cooper-campbell/senior_design_pcb_schematic/ratsnest.png

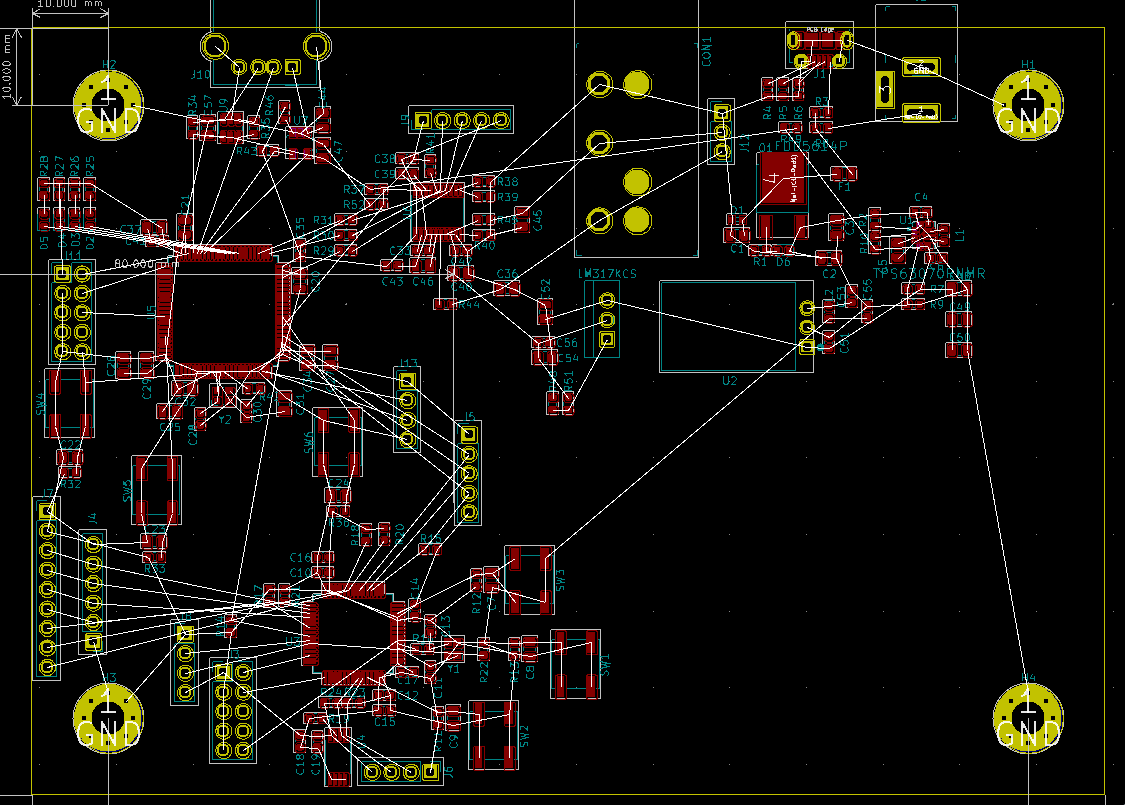
ratsnest.png
