cooper-campbell/senior_design_pcb_schematic/mosfet/eec.models/ON_Semi_-_FDD5614P.step

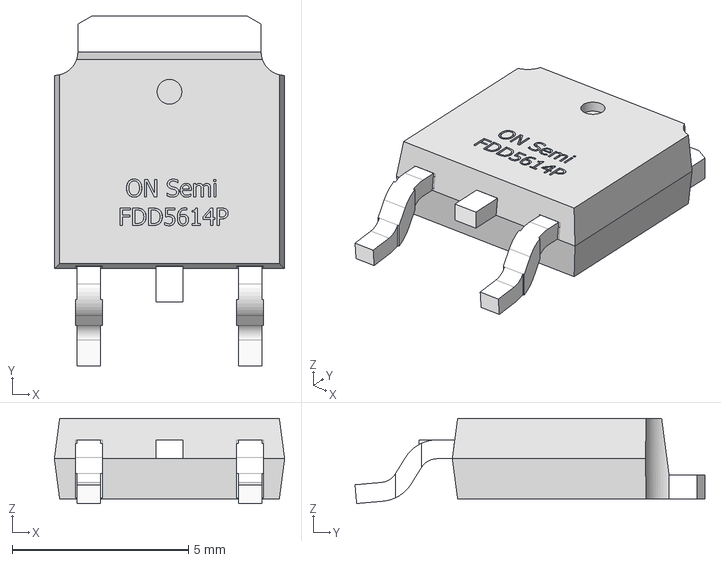
[picture p2: CAD file, 2021-03-15]
mosfet/eec.models/ON_Semi_-_FDD5614P.step
6.54 x 9.94 x 2.42 mm
