cooper-campbell/senior_design_pcb_schematic/ti/eec.models/Texas_Instruments_-_TPS63070RNMR.step

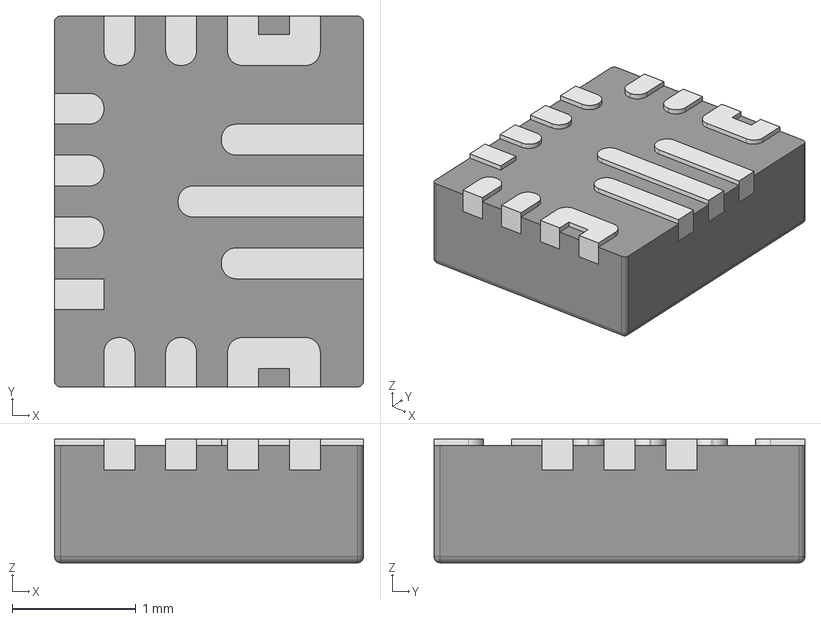
[picture p3: CAD file, 2021-03-14]
ti/eec.models/Texas_Instruments_-_TPS63070RNMR.step
2.50 x 3.00 x 1.00 mm
Texas Instruments TPS63070RNMT 1
Texas Instruments TPS63070RNMT 2
Texas ss
