cooper-campbell/senior_design_pcb_schematic/v7803/V7803-1500R.step

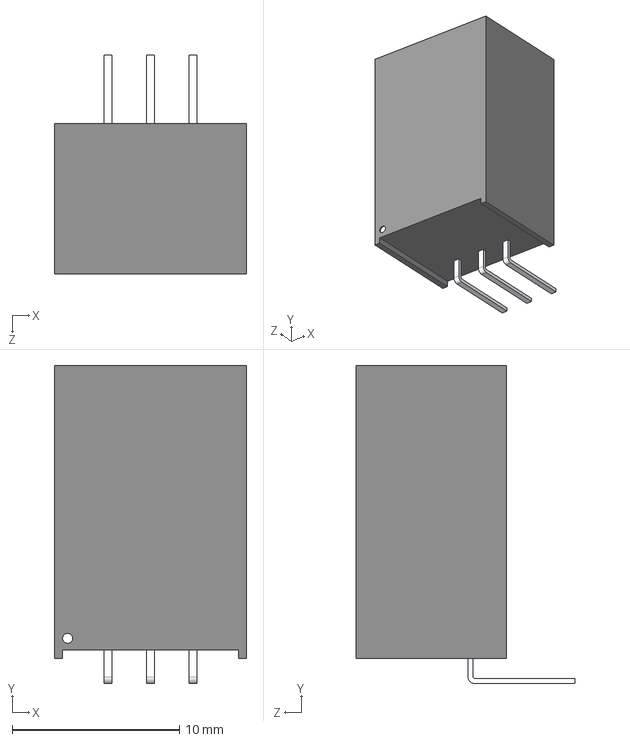
[picture p4: CAD file, 2021-03-17]
v7803/V7803-1500R.step
11.5 x 19.0 x 13.1 mm
