cooper-campbell/senior_design_pcb_schematic/pcb_layout.pdf

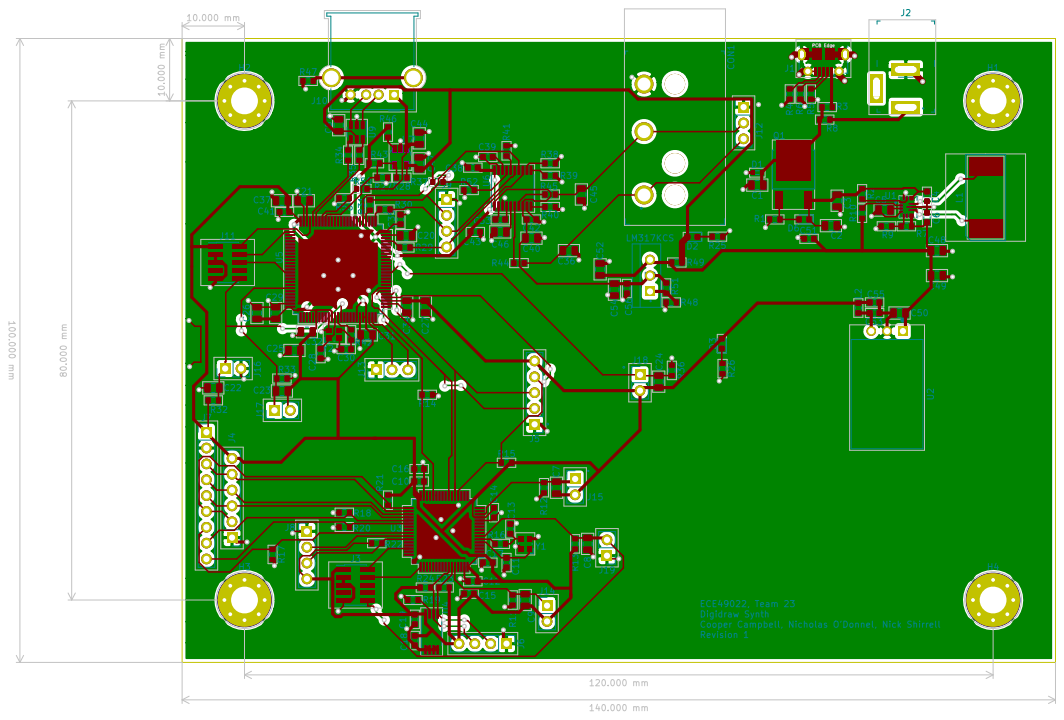
[picture p8: page 1]
