cooper-campbell/senior_design_pcb_schematic/digidraw.kicad_pcb

## KiCad design digidraw.kicad_pcb (2021-04-12)

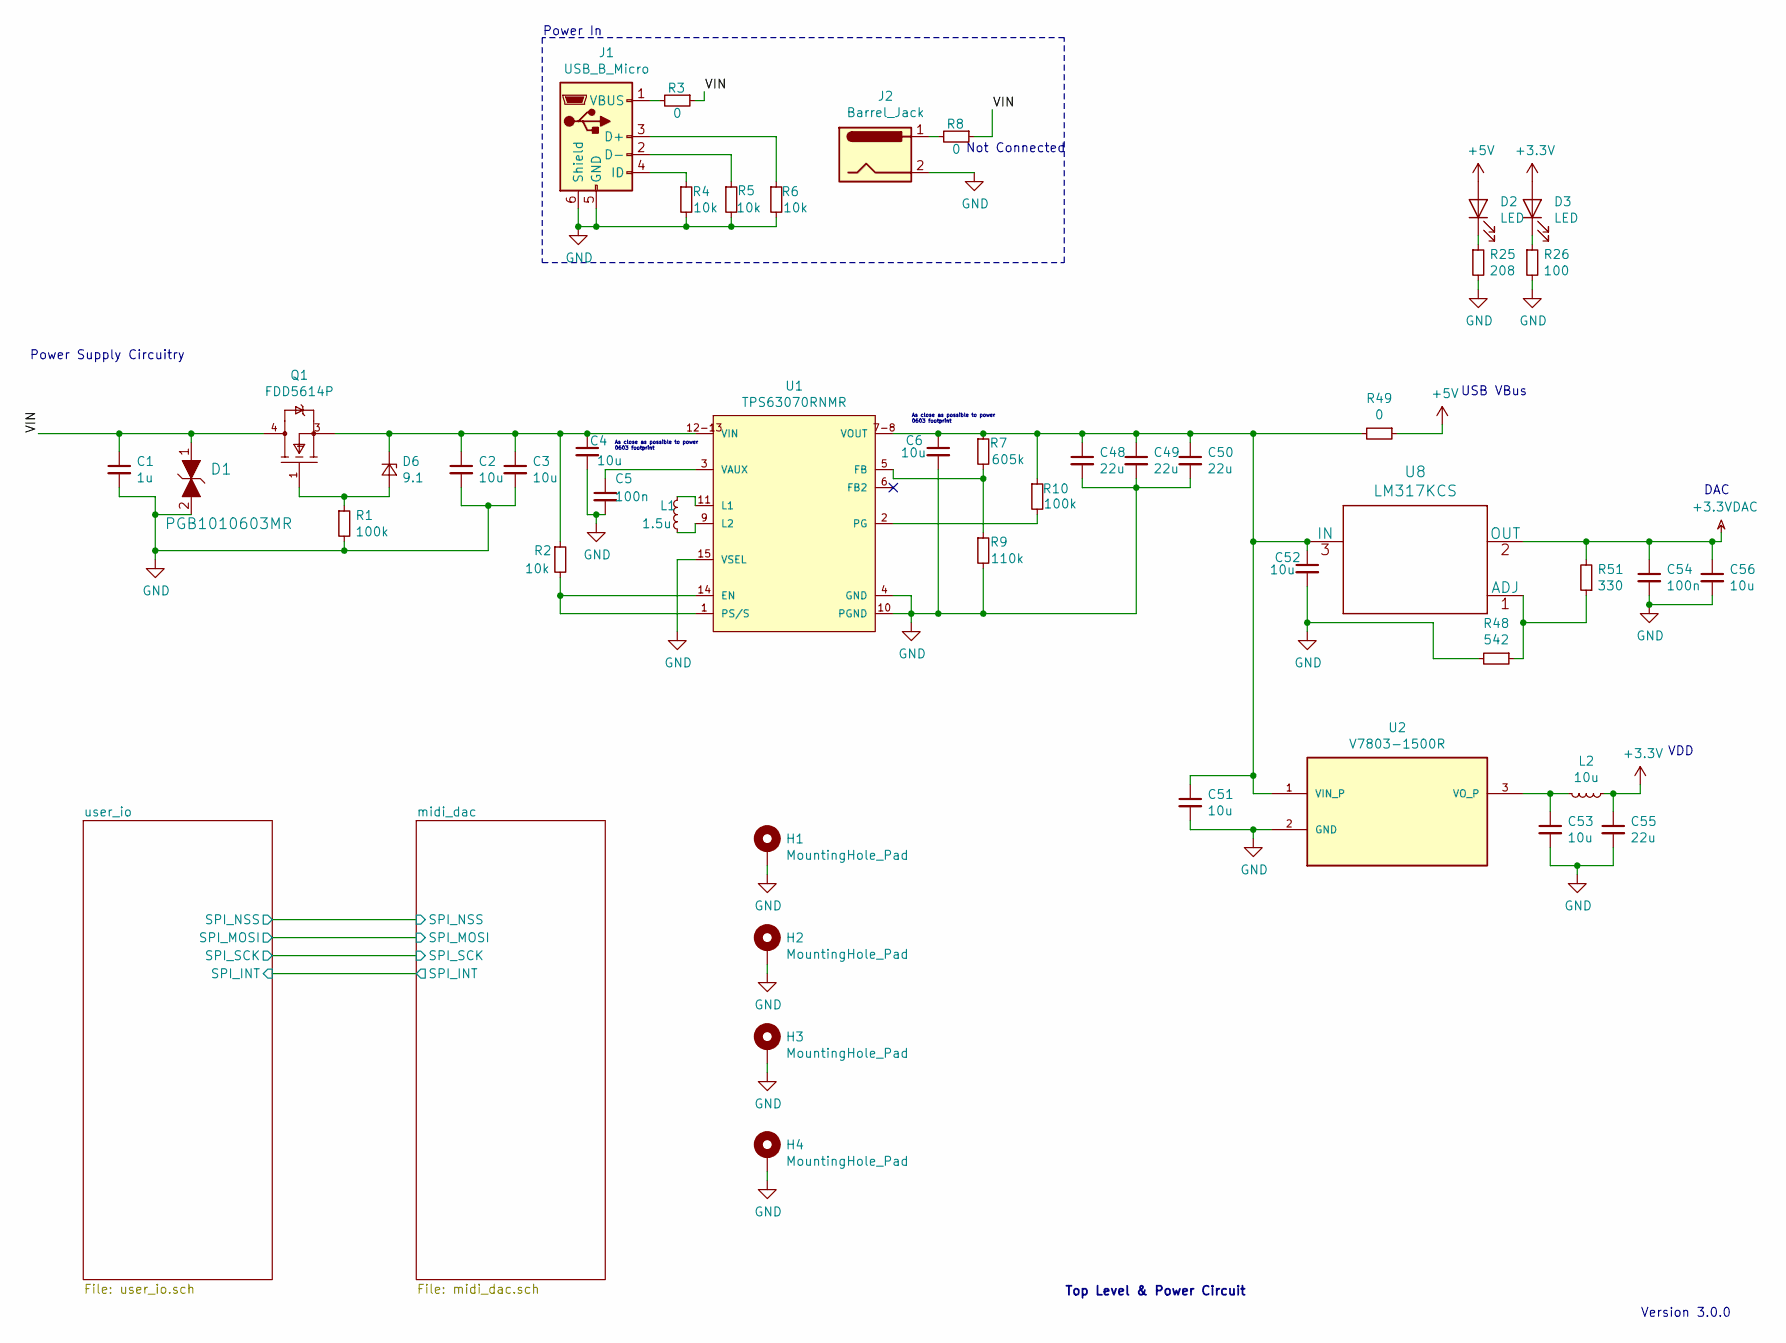
[picture p9: schematic digidraw.sch]

Parts:
C1: 1u; C_0805_2012Metric; Min Voltage Rating 16 V
C2, C3: 10u; C_0805_2012Metric; Min Voltage Rating 16 V
C4: 10u; C_0603_1608Metric; Min Voltage Rating 16 V
C5: 100n; C_0805_2012Metric; Min Voltage Rating 16 V
C6: 10u; C_0603_1608Metric; Min Voltage Rating 5.2 V
C48, C49, C50: 22u; C_0805_2012Metric; Min Voltage Rating 5.2 V
C51, C53: 10u; C_0603_1608Metric
C52: 10u; C_0805_2012Metric; Min Voltage Rating 5.2 V
C54: 100n; C_0805_2012Metric; Min Voltage Rating 3.3 V
C55: 22u; C_0603_1608Metric; Min Voltage Rating 3.3 V
C56: 10u; C_0603_1608Metric; Min Voltage Rating 3.3 V
D1: PGB1010603MR; 0603; MPN PGB1010603MR; Digi-Key_PN F2594CT-ND
D2, D3: LED; LED_0603_1608Metric; Digi-Key_PN AA1608SURSK
D6: 9.1; D_0603_1608Metric; Digi-Key_PN CDBU0320
H1, H2, H3, H4: MountingHole_Pad; MountingHole_4.3mm_M4_Pad_Via
J1: USB_B_Micro; USB_Micro-B_Molex-105017-0001; Digi-Key_PN 105017-0001
J2: Barrel_Jack; Barrel_Jack_5.5mmODx2.1mmID_PJ-202A; Digi-Key_PN PJ-202A
L1: 1.5u; InductorWEPD; Digi-Key_PN 7447707015
L2: 10u; L_0603_1608Metric; Digi-Key_PN MLZ1608E100MT
Q1: FDD5614P; ON_Semi-369AS-09_2016-O-0; mouser part number 512-FDD5614P; digikey description MOSFET P-CH 60V 15A DPAK
R1, R10: 100k; R_0603_1608Metric
R2, R4, R5, R6: 10k; R_0603_1608Metric
R3, R8, R49: 0; R_0603_1608Metric
R7: 605k; R_0603_1608Metric
R9: 110k; R_0603_1608Metric
R25: 208; R_0603_1608Metric
R26: 100; R_0603_1608Metric
R48: 542; R_0603_1608Metric
R51: 330; R_0603_1608Metric
U1: TPS63070RNMR; Texas_Instruments-RNM0015A-0-0-MFG; output voltage 2.5-9V; mouser part number 595-TPS63070RNMR; digikey description IC REG BCK BST ADJ 3.6A 15VQFN
U2: V7803-1500R; CONV_V7803-1500R; PARTREV 1.03; Digi-Key_PN V7803-1500R
U8: LM317KCS; Digi-Key_PN LM317KCS

Connections:
+3.3VDAC: C54.1, C56.1, R51.2, U8.2 (OUT); also elsewhere on the board
+3V3: C55.1, D3.2 (A), L2.1; also elsewhere on the board
+5V: D2.2 (A), R49.1; also elsewhere on the board
/VIN: C1.1, D1.1, Q1.4 (D), R3.1, R8.1
GND: C1.2, C2.2, C3.2, C4.2, C5.2, C6.2, C48.2, C49.2, C50.2, C51.2, C52.2, C53.2, C54.2, C55.2, C56.2, D1.2, H1.1, H2.1, H3.1, H4.1, J1.5 (GND), J1.6 (Shield), J2.2, R1.2, R4.2, R5.2, R6.2, R9.2, R25.2, R26.2, R48.2, U1.4 (GND), U1.10 (PGND), U1.15 (VSEL), U2.2 (GND); also elsewhere on the board
unnamed: C2.1, C3.1, C4.1, D6.1 (K), Q1.3 (S), R2.1, U1.12-13 (VIN)
unnamed: C5.1, U1.3 (VAUX)
unnamed: C6.1, C48.1, C49.1, C50.1, C51.1, C52.1, R7.1, R10.1, R49.2, U1.7-8 (VOUT), U2.1 (VIN_P), U8.3 (IN)
unnamed: C53.1, L2.2, U2.3 (VO_P)
unnamed: D2.1 (K), R25.1
unnamed: D3.1 (K), R26.1
unnamed: D6.2 (A), Q1.1 (G), R1.1
unnamed: J1.1 (VBUS), R3.2
unnamed: J1.2 (D-), R5.1
unnamed: J1.3 (D+), R6.1
unnamed: J1.4 (ID), R4.1
unnamed: J2.1, R8.2
unnamed: L1.1, U1.9 (L2)
unnamed: L1.2, U1.11 (L1)
unnamed: R2.2, U1.1 (PS/S), U1.14 (EN)
unnamed: R7.2, R9.1, U1.5 (FB)
unnamed: R10.2, U1.2 (PG)
unnamed: R48.1, R51.1, U8.1 (ADJ)

Notes on the sheet:
Power In
Top Level & Power Circuit
Version 3.0.0
Not Connected
As close as possible to power 0603 footprint
USB VBus
VDD
DAC
Power Supply Circuitry

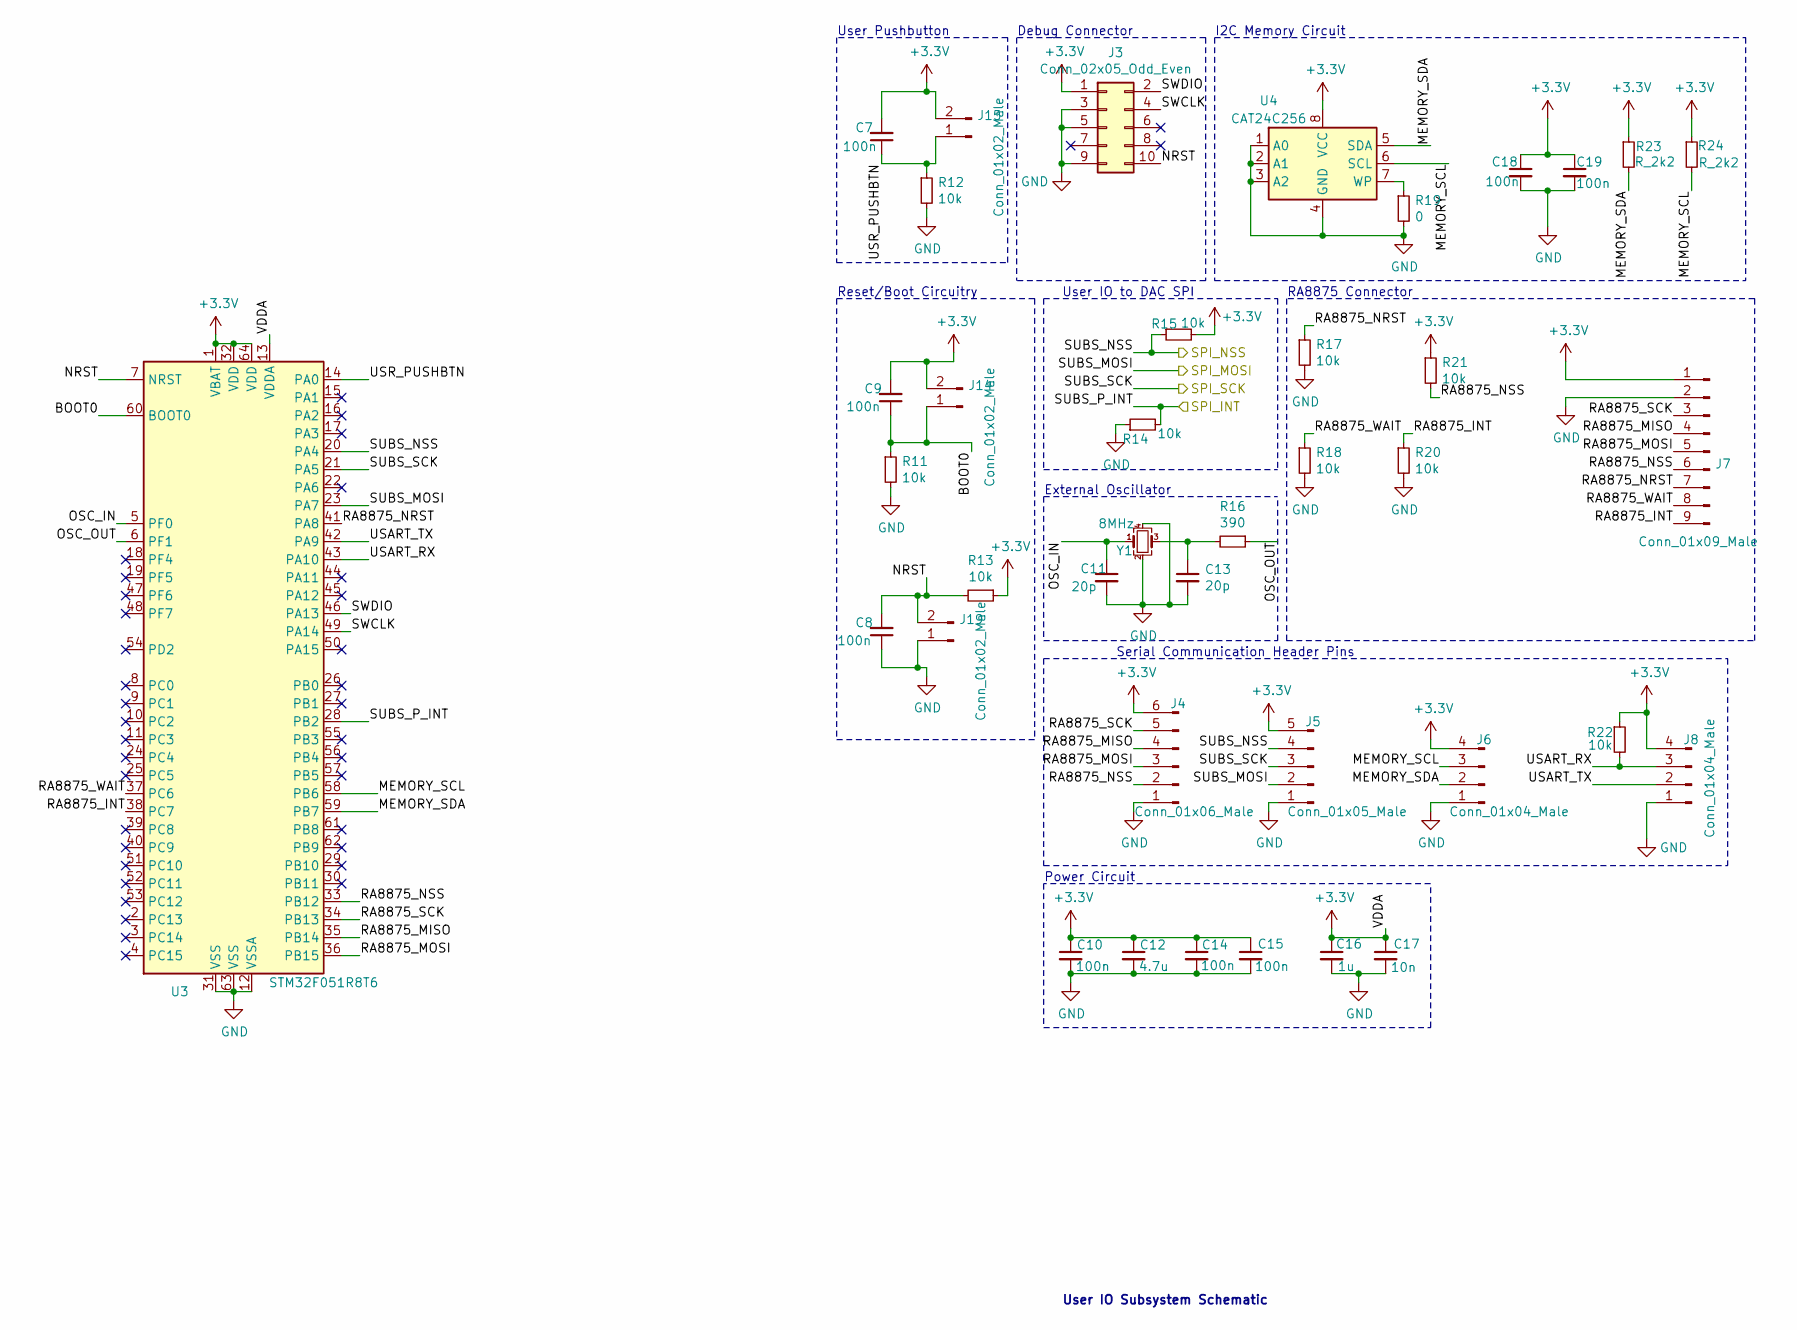
[picture p10: schematic user_io.sch]

Parts:
C7, C8, C9: 100n; C_0805_2012Metric; Min Voltage Rating 3.3 V
C10, C14, C15, C18, C19: 100n; C_0603_1608Metric; Min Voltage Rating 3.3 V
C11, C13: 20p; C_0603_1608Metric; Min Voltage Rating 3.3 V
C12: 4.7u; C_0603_1608Metric; Min Voltage Rating 3.3 V
C16: 1u; C_0603_1608Metric; Min Voltage Rating 3.3 V
C17: 10n; C_0603_1608Metric
J3: Conn_02x05_Odd_Even; PinHeader_2x05_P1.27mm_Vertical_SMD
J4: Conn_01x06_Male; PinHeader_1x06_P2.54mm_Vertical
J5: Conn_01x05_Male; PinHeader_1x05_P2.54mm_Vertical
J6, J8: Conn_01x04_Male; PinHeader_1x04_P2.54mm_Vertical
J7: Conn_01x09_Male; PinHeader_1x09_P2.54mm_Vertical
J14, J15, J19: Conn_01x02_Male; PinHeader_1x02_P2.54mm_Vertical
R11, R12, R13, R14, R15, R17, R18, R20, R21, R22: 10k; R_0603_1608Metric
R16: 390; R_0603_1608Metric
R19: 0; R_0603_1608Metric
R23, R24: R_2k2; R_0603_1608Metric
U3: STM32F051R8T6; LQFP-64_10x10mm_P0.5mm; Digi-Key_PN STM32F051R8T6
U4: CAT24C256; TSSOP-8_4.4x3mm_P0.65mm; Digi-Key_PN CAT24C256YI-GT3
Y1: 8MHz; Crystal_SMD_Abracon_ABM10-4Pin_2.5x2.0mm; Digi-Key_PN ASDDV-8.000MHZ-LR-T

Connections:
+3V3: C7.2, C9.2, C10.1, C12.1, C14.1, C15.1, C16.1, C17.1, C18.1, C19.1, J3.1, J4.6, J5.5, J6.4, J7.1, J8.4, J14.2, J15.2, R13.1, R15.2, R21.1, R22.1, R23.1, R24.1, U3.1 (VBAT), U3.13 (VDDA), U3.32 (VDD), U3.64 (VDD), U4.8 (VCC); also elsewhere on the board
/midi_dac/SPI_INT: R14.2, U3.28 (PB2); also elsewhere on the board
/midi_dac/SPI_MOSI: J5.2, U3.23 (PA7); also elsewhere on the board
/midi_dac/SPI_NSS: J5.4, R15.1, U3.20 (PA4); also elsewhere on the board
/midi_dac/SPI_SCK: J5.3, U3.21 (PA5); also elsewhere on the board
/user_io/BOOT0: C9.1, J14.1, R11.1, U3.60 (BOOT0)
/user_io/MEMORY_SCL: J6.3, R24.2, U3.58 (PB6), U4.6 (SCL)
/user_io/MEMORY_SDA: J6.2, R23.2, U3.59 (PB7), U4.5 (SDA)
/user_io/NRST: C8.2, J3.10, J19.2, R13.2, U3.7 (NRST)
/user_io/OSC_IN: C11.1, U3.5 (PF0), Y1.1
/user_io/OSC_OUT: R16.1, U3.6 (PF1)
/user_io/RA8875_INT: J7.9, R20.1, U3.38 (PC7)
/user_io/RA8875_MISO: J4.4, J7.4, U3.35 (PB14)
/user_io/RA8875_MOSI: J4.3, J7.5, U3.36 (PB15)
/user_io/RA8875_NRST: J7.7, R17.1, U3.41 (PA8)
/user_io/RA8875_NSS: J4.2, J7.6, R21.2, U3.33 (PB12)
/user_io/RA8875_SCK: J4.5, J7.3, U3.34 (PB13)
/user_io/RA8875_WAIT: J7.8, R18.1, U3.37 (PC6)
/user_io/SWCLK: J3.4, U3.49 (PA14)
/user_io/SWDIO: J3.2, U3.46 (PA13)
/user_io/USART_RX: J8.3, R22.2, U3.43 (PA10)
/user_io/USART_TX: J8.2, U3.42 (PA9)
/user_io/USR_PUSHBTN: C7.1, J15.1, R12.1, U3.14 (PA0)
GND: C8.1, C10.2, C11.2, C12.2, C13.2, C14.2, C15.2, C16.2, C17.2, C18.2, C19.2, J3.3, J3.5, J3.9, J4.1, J5.1, J6.1, J7.2, J8.1, J19.1, R11.2, R12.2, R14.1, R17.2, R18.2, R19.2, R20.2, U3.12 (VSSA), U3.31 (VSS), U3.63 (VSS), U4.1 (A0), U4.2 (A1), U4.3 (A2), U4.4 (GND), Y1.2, Y1.4; also elsewhere on the board
unnamed: C13.1, R16.2, Y1.3
unnamed: R19.1, U4.7 (WP)

Notes on the sheet:
I2C Memory Circuit
User IO to DAC SPI
RA8875 Connector
User IO Subsystem Schematic
Reset/Boot Circuitry
Debug Connector
Power Circuit
Serial Communication Header Pins
External Oscillator
User Pushbutton

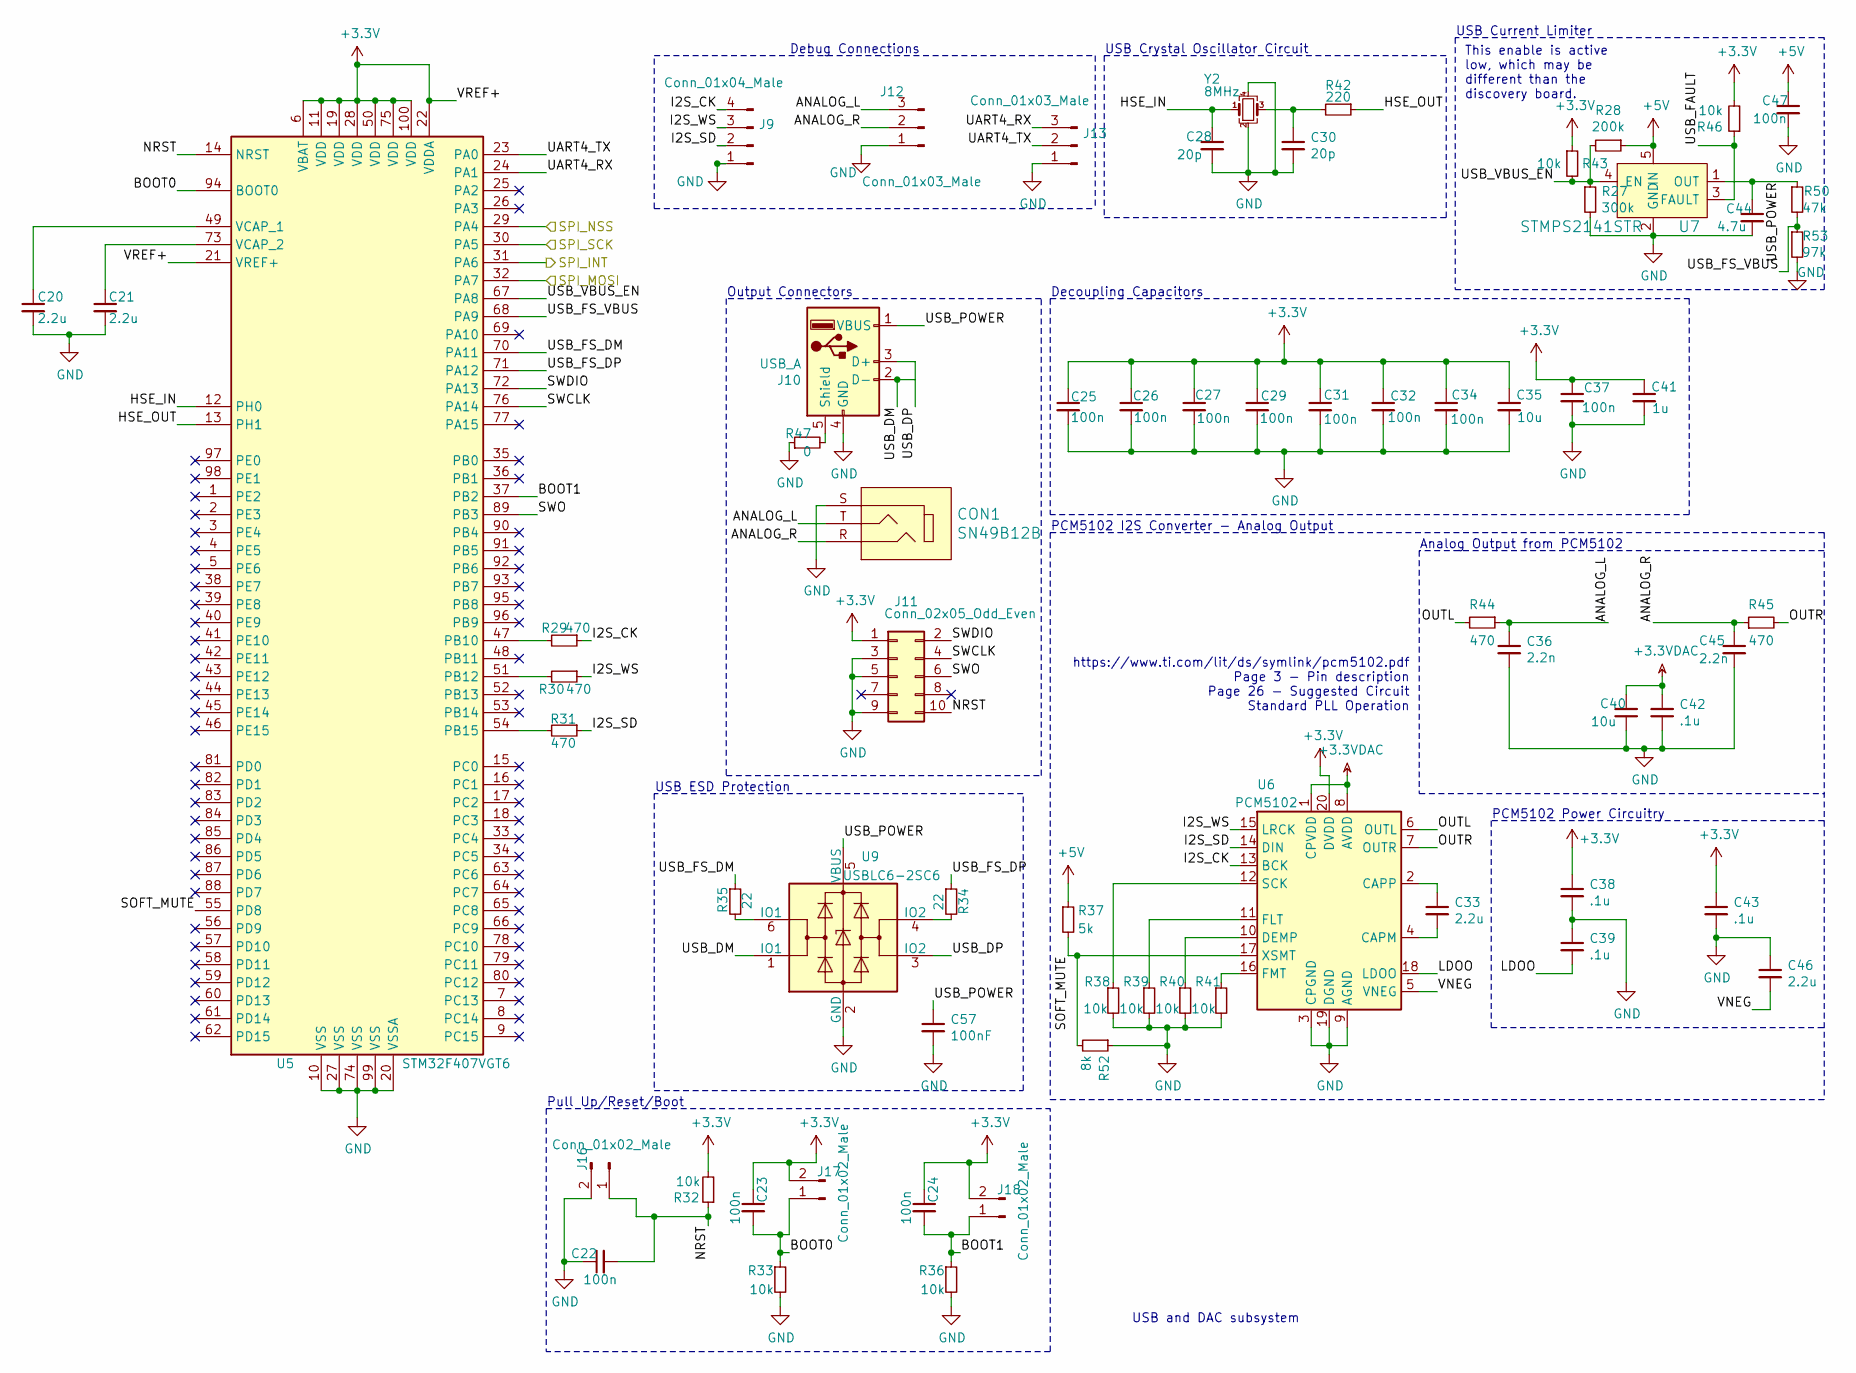
[picture p11: schematic midi_dac.sch]

Parts:
C20, C21, C46: 2.2u; C_0805_2012Metric; Min Voltage Rating 3.3 V
C22, C23, C24, C25, C26, C27, C29, C31, C32, C34, C37: 100n; C_0805_2012Metric; Min Voltage Rating 3.3 V
C28, C30: 20p; C_0603_1608Metric; Min Voltage Rating 3.3 V
C33: 2.2u; C_0603_1608Metric; Min Voltage Rating 3.3 V
C35: 10u; C_0603_1608Metric; Min Voltage Rating 3.3 V
C36, C45: 2.2n; C_0805_2012Metric; Min Voltage Rating 3.3 V
C38, C39, C42, C43: .1u; C_0603_1608Metric; Min Voltage Rating 3.3 V
C40: 10u; C_0805_2012Metric; Min Voltage Rating 3.3 V
C41: 1u; C_0603_1608Metric; Min Voltage Rating 3.3 V
C44: 4.7u; C_0805_2012Metric; Min Voltage Rating 5.2 V
C47: 100n; C_0805_2012Metric; Min Voltage Rating 5.2 V
C57: 100nF; C_0805_2012Metric; Min Voltage Rating 5.2 V
CON1: SN49B12B; Headphone_Jack_6.35mm_SN49B12B; MPN SN49B12B; Digi-Key_PN SC1522-ND
J9: Conn_01x04_Male; PinHeader_1x04_P2.54mm_Vertical
J10: USB_A; USB_A_Molex_67643_Horizontal; Digi-Key_PN 67643-3910
J11: Conn_02x05_Odd_Even; PinHeader_2x05_P1.27mm_Vertical_SMD
J12, J13: Conn_01x03_Male; PinHeader_1x03_P2.54mm_Vertical
J16, J17, J18: Conn_01x02_Male; PinHeader_1x02_P2.54mm_Vertical
R27: 300k; R_0603_1608Metric
R28: 200k; R_0603_1608Metric
R29, R30, R31, R44, R45: 470; R_0603_1608Metric
R32, R33, R36, R38, R39, R40, R41, R43, R46: 10k; R_0603_1608Metric
R34, R35: 22; R_0603_1608Metric
R37: 5k; R_0603_1608Metric
R42: 220; R_0603_1608Metric
R47: 0; R_0603_1608Metric
R50: 47k; R_0603_1608Metric
R52: 8k; R_0603_1608Metric
R53: 97k; R_0603_1608Metric
U5: STM32F407VGT6; LQFP-100_14x14mm_P0.5mm; Digi-Key_PN STM32F407VGT6
U6: PCM5102; TSSOP-20_4.4x6.5mm_P0.65mm; Digi-Key_PN PCM5102APWR
U7: STMPS2141STR; SOT-753; MPN STMPS2141STR; Digi-Key_PN 497-6933-1-ND
U9: USBLC6-2SC6; SOT-23-6; Digi-Key_PN USBLC6-2SC6
Y2: 8MHz; Crystal_SMD_Abracon_ABM10-4Pin_2.5x2.0mm; Digi-Key_PN ASDDV-8.000MHZ-LR-T

Connections:
+3.3VDAC: C40.2, C42.2, U6.1 (CPVDD), U6.8 (AVDD); also elsewhere on the board
+3V3: C23.1, C24.1, C25.1, C26.1, C27.1, C29.1, C31.1, C32.1, C34.1, C35.1, C37.1, C38.1, C41.1, C43.1, J11.1, J17.2, J18.2, R32.2, R43.1, R46.2, U5.6 (VBAT), U5.11 (VDD), U5.19 (VDD), U5.21 (VREF+), U5.22 (VDDA), U5.28 (VDD), U5.50 (VDD), U5.75 (VDD), U5.100 (VDD), U6.20 (DVDD); also elsewhere on the board
+5V: C47.1, R28.1, R37.1, U7.5 (IN); also elsewhere on the board
/midi_dac/ANALOG_L: C36.1, CON1.T, J12.3, R44.1
/midi_dac/ANALOG_R: C45.1, CON1.R, J12.2, R45.1
/midi_dac/BOOT0: C23.2, J17.1, R33.1, U5.94 (BOOT0)
/midi_dac/BOOT1: C24.2, J18.1, R36.1, U5.37 (PB2)
/midi_dac/HSE_IN: C28.1, U5.12 (PH0), Y2.1
/midi_dac/HSE_OUT: R42.1, U5.13 (PH1)
/midi_dac/I2S_CK: J9.4, R29.1, U6.13 (BCK)
/midi_dac/I2S_SD: J9.2, R31.1, U6.14 (DIN)
/midi_dac/I2S_WS: J9.3, R30.1, U6.15 (LRCK)
/midi_dac/LDOO: C39.2, U6.18 (LDOO)
/midi_dac/NRST: C22.2, J11.10, J16.1, R32.1, U5.14 (NRST)
/midi_dac/OUTL: R44.2, U6.6 (OUTL)
/midi_dac/OUTR: R45.2, U6.7 (OUTR)
/midi_dac/SOFT_MUTE: R37.2, R52.2, U5.55 (PD8), U6.17 (XSMT)
/midi_dac/SPI_INT: U5.31 (PA6); also elsewhere on the board
/midi_dac/SPI_MOSI: U5.32 (PA7); also elsewhere on the board
/midi_dac/SPI_NSS: U5.29 (PA4); also elsewhere on the board
/midi_dac/SPI_SCK: U5.30 (PA5); also elsewhere on the board
/midi_dac/SWCLK: J11.4, U5.76 (PA14)
/midi_dac/SWDIO: J11.2, U5.72 (PA13)
/midi_dac/SWO: J11.6, U5.89 (PB3)
/midi_dac/UART4_RX: J13.3, U5.24 (PA1)
/midi_dac/UART4_TX: J13.2, U5.23 (PA0)
/midi_dac/USB_DM: J10.2 (D-), U9.1 (IO1)
/midi_dac/USB_DP: J10.3 (D+), U9.3 (IO2)
/midi_dac/USB_FAULT: R46.1, U7.3 (FAULT)
/midi_dac/USB_FS_DM: R35.1, U5.70 (PA11)
/midi_dac/USB_FS_DP: R34.1, U5.71 (PA12)
/midi_dac/USB_FS_VBUS: R50.2, R53.1, U5.68 (PA9)
/midi_dac/USB_POWER: C44.1, C57.1, J10.1 (VBUS), R50.1, U7.1 (OUT), U9.5 (VBUS)
/midi_dac/USB_VBUS_EN: R27.1, R28.2, R43.2, U5.67 (PA8), U7.4 (EN)
/midi_dac/VNEG: C46.2, U6.5 (VNEG)
GND: C20.2, C21.2, C22.1, C25.2, C26.2, C27.2, C28.2, C29.2, C30.2, C31.2, C32.2, C34.2, C35.2, C36.2, C37.2, C38.2, C39.1, C40.1, C41.2, C42.1, C43.2, C44.2, C45.2, C46.1, C47.2, C57.2, CON1.S, J9.1, J10.4 (GND), J11.3, J11.5, J11.9, J12.1, J13.1, J16.2, R27.2, R33.2, R36.2, R38.2, R39.2, R40.2, R41.2, R47.1, R52.1, R53.2, U5.10 (VSS), U5.20 (VSSA), U5.27 (VSS), U5.74 (VSS), U5.99 (VSS), U6.3 (CPGND), U6.9 (AGND), U6.19 (DGND), U7.2 (GND), U9.2 (GND), Y2.2, Y2.4; also elsewhere on the board
unnamed: C20.1, U5.49 (VCAP_1)
unnamed: C21.1, U5.73 (VCAP_2)
unnamed: C30.1, R42.2, Y2.3
unnamed: C33.1, U6.2 (CAPP)
unnamed: C33.2, U6.4 (CAPM)
unnamed: J10.5 (Shield), R47.2
unnamed: R29.2, U5.47 (PB10)
unnamed: R30.2, U5.51 (PB12)
unnamed: R31.2, U5.54 (PB15)
unnamed: R34.2, U9.4 (IO2)
unnamed: R35.2, U9.6 (IO1)
unnamed: R38.1, U6.12 (SCK)
unnamed: R39.1, U6.11 (FLT)
unnamed: R40.1, U6.10 (DEMP)
unnamed: R41.1, U6.16 (FMT)

Notes on the sheet:
Decoupling Capacitors
USB Crystal Oscillator Circuit
https://www.ti.com/lit/ds/symlink/pcm5102.pdf Page 3 - Pin description Page 26 - Suggested Circuit Standard PLL Operation
Analog Output from PCM5102
PCM5102 Power Circuitry
PCM5102 I2S Converter - Analog Output
This enable is active low, which may be different than the discovery board.
USB Current Limiter
Pull Up/Reset/Boot
Output Connectors
USB and DAC subsystem
Debug Connections
USB ESD Protection

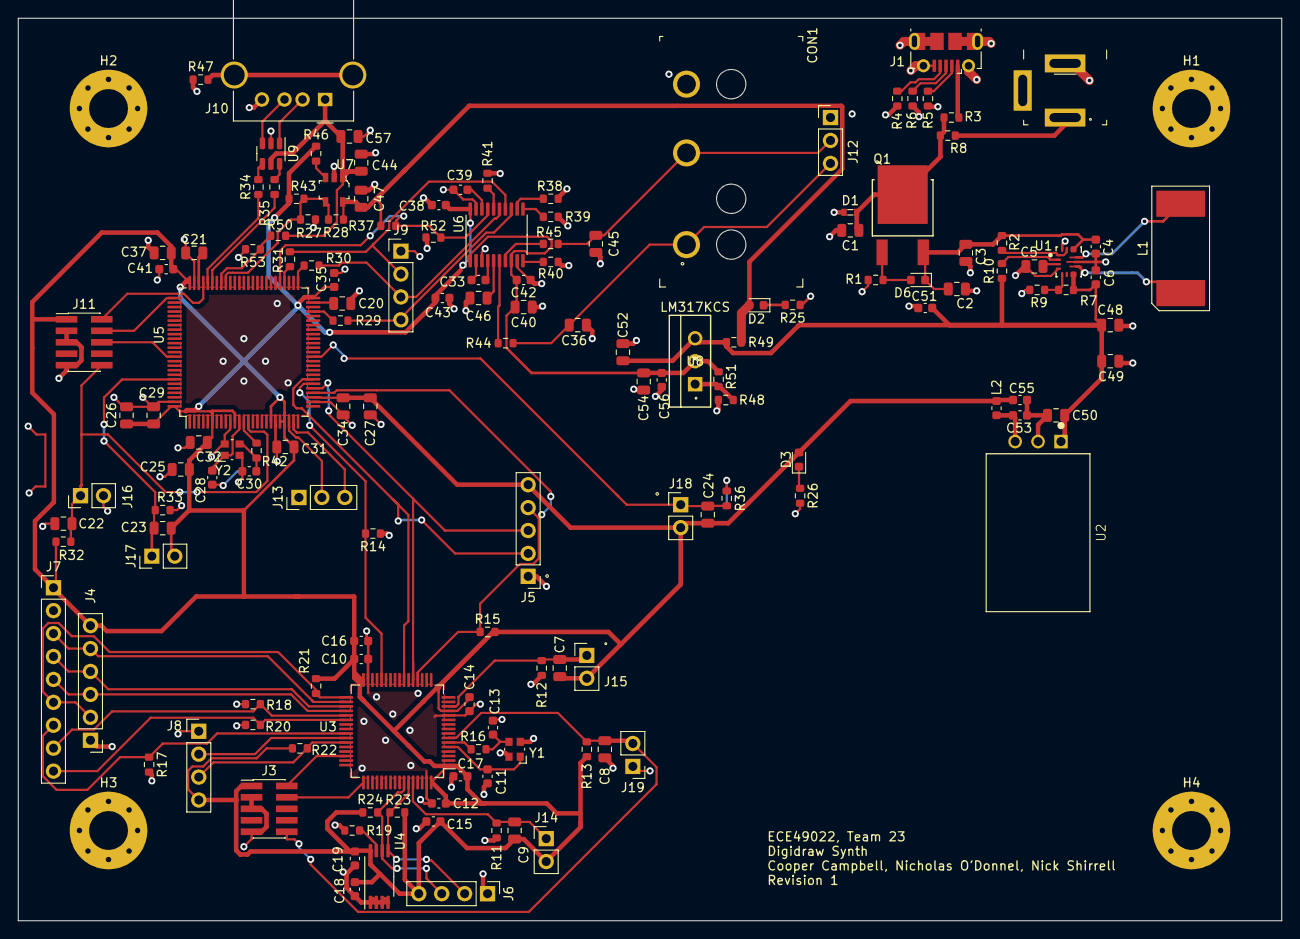
[picture p12: board digidraw.kicad_pcb from above]

Board: 2 copper layers, 140.0 x 100.0 mm, 152 parts (0 on the bottom side), 90 nets.
