cooper-campbell/senior_design_pcb_schematic/(commit log)

2021-03-07 Initial, add mcus
    [digidraw.kicad_pcb, digidraw.sch, midi_dac.sch, user_io.sch]
2021-03-07 Work on user io subsystem schematic
    [digidraw.sch, midi_dac.sch, user_io.sch]
2021-03-09 Add f4 decoupling capacitors, add dac, add power converter circuit
    [digidraw.sch, midi_dac.sch, user_io.sch]
2021-03-12 Finish prototype of DAC/USB/Power system
    [digidraw.sch, midi_dac.sch, user_io.sch]
2021-03-12 Finish screen subsystem
    [midi_dac.sch, user_io.sch]
2021-03-12 Add one more debug connector
    [digidraw.sch, midi_dac.sch]
2021-03-12 Add mounting holes
    [digidraw.sch]
2021-03-13 Make updates per suggestions
    [digidraw.sch, midi_dac.sch, user_io.sch]
2021-03-13 Change the side that the resistors are on
    [midi_dac.sch]
2021-03-14 Make most changes for final design
    [midi_dac.sch, user_io.sch]
2021-03-14 Update power supply system
    [Texas_Instruments_-_TPS63070RNMR.step, digidraw.sch, midi_dac.sch]
2021-03-15 Final iteration before pcb design review
    [ON_Semi_-_FDD5614P.step, digidraw.sch, midi_dac.sch, user_io.sch]
2021-03-15 Finish schematic
    [digidraw.sch, digidraw_bom.csv, midi_dac.sch, user_io.sch]
2021-03-17 Get everything on board, use buck converter, chnage lm317 footprint
    [V7803-1500R.step, digidraw.kicad_pcb, digidraw.sch]
2021-03-17 Decent layout at first glance
    [digidraw.kicad_pcb, midi_dac.sch]
2021-03-17 Work on pcb layout
    [digidraw.kicad_pcb, midi_dac.sch, user_io.sch]
2021-03-18 Replace components
    [digidraw.kicad_pcb, midi_dac.sch, user_io.sch]
2021-03-19 Huge progress on routing
    [digidraw.kicad_pcb, digidraw.sch, midi_dac.sch, user_io.sch]
2021-03-19 Finish initial layout
    [digidraw.kicad_pcb, midi_dac.sch, user_io.sch]
2021-03-19 Add gerber files
    [digidraw-B_Cu.gbr, digidraw-B_Mask.gbr, digidraw-Edge_Cuts.gbr, digidraw-F_Cu.gbr, digidraw-F_Mask.gbr, digidraw-F_Paste.gbr, digidraw-F_SilkS.gbr, digidraw-job.gbrjob]
2021-03-19 Documentation for submission
    [digidraw-B_Cu.gbr, digidraw-B_Mask.gbr, digidraw-Edge_Cuts.gbr, digidraw-F_Cu.gbr, digidraw-F_Mask.gbr, digidraw-F_Paste.gbr, digidraw-F_SilkS.gbr, digidraw-job.gbrjob]
2021-03-24 Update pcb layout
    [digidraw.kicad_pcb]
2021-03-24 PCB changes
    [digidraw-B_Cu.gbr, digidraw-B_Mask.gbr, digidraw-Edge_Cuts.gbr, digidraw-F_Cu.gbr, digidraw-F_Mask.gbr, digidraw-F_Paste.gbr, digidraw-F_SilkS.gbr, digidraw-job.gbrjob]
